bmander/interferometer/renders/cube_section_side.png

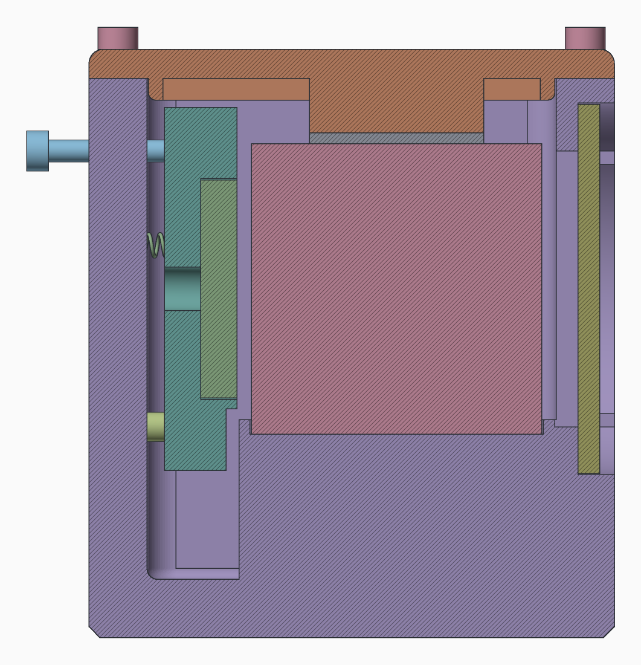
renders/cube_section_side.png
