bmander/interferometer/renders/mount_front.png

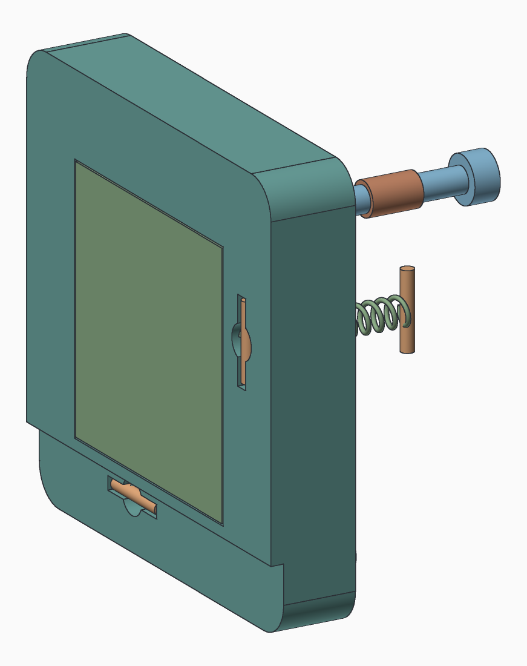
renders/mount_front.png
