bmander/interferometer/stl/carriage.stl

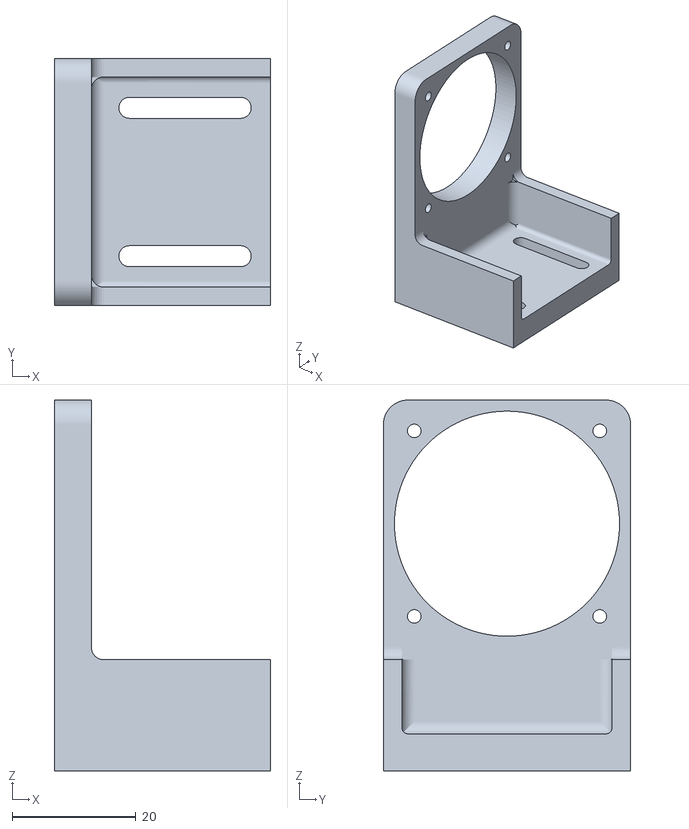
[picture p6: CAD file, 2026-11-11]
stl/carriage.stl
35.0 x 40.0 x 60.0
