bmander/interferometer/stl/housing.stl

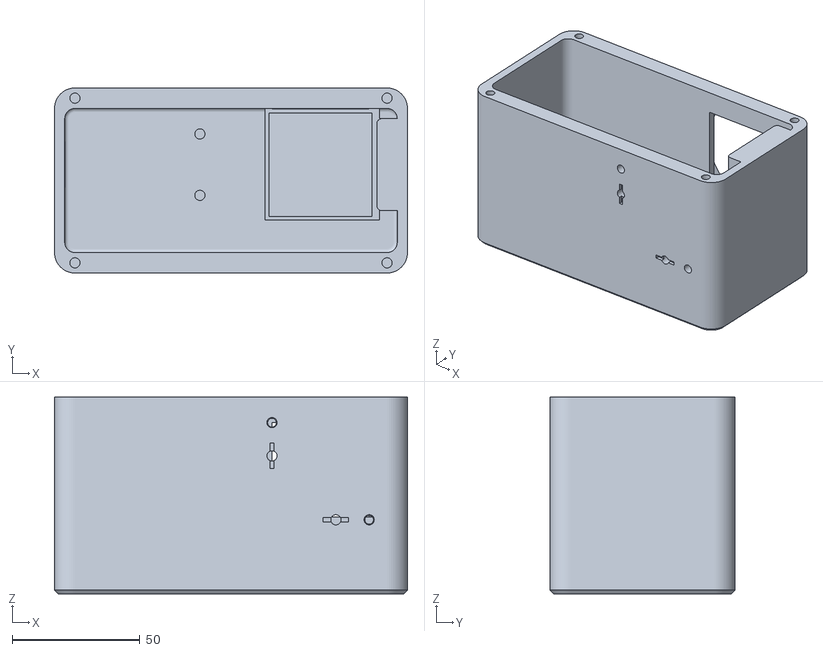
[picture p7: CAD file, 2026-11-11]
stl/housing.stl
138.1 x 72.4 x 77.0
