bmander/interferometer/stl/carrier.stl

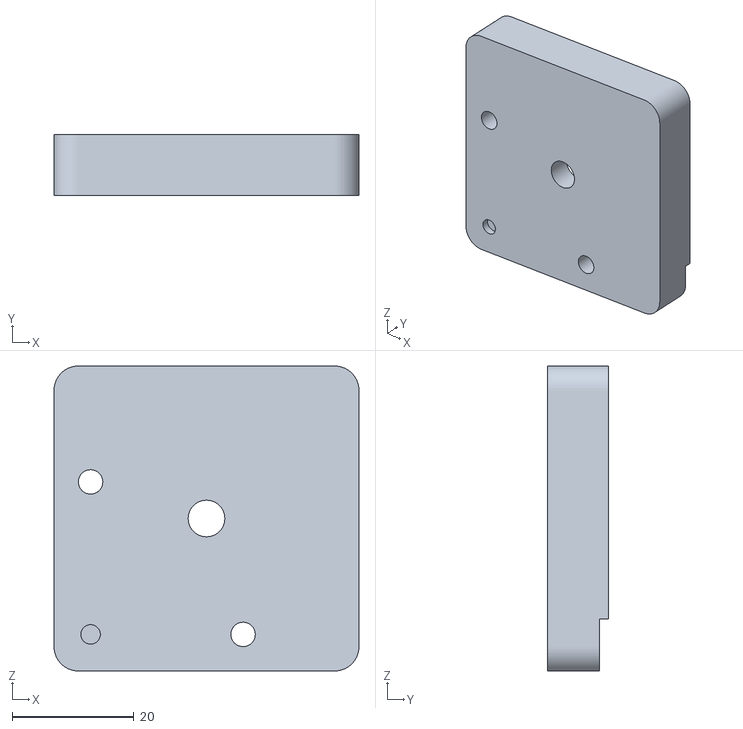
[picture p8: CAD file, 2026-11-11]
stl/carrier.stl
50.0 x 10.0 x 50.0
