bmander/interferometer/stl/lid.stl

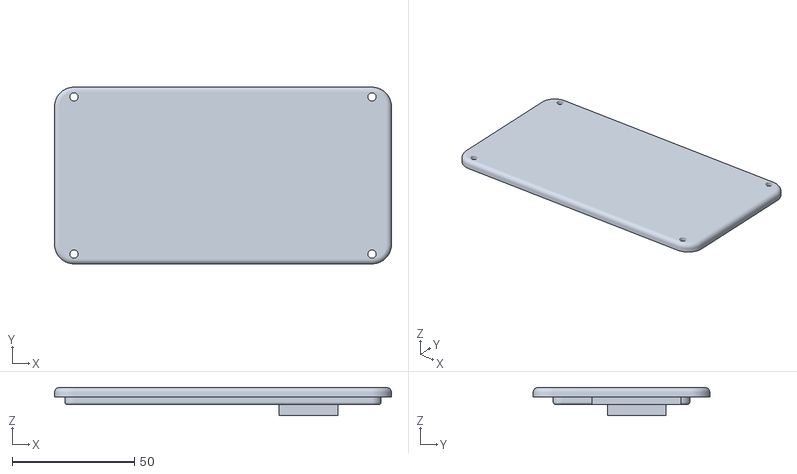
[picture p9: CAD file, 2026-11-11]
stl/lid.stl
138.1 x 72.4 x 11.5
