bmander/interferometer/renders/assembly.png

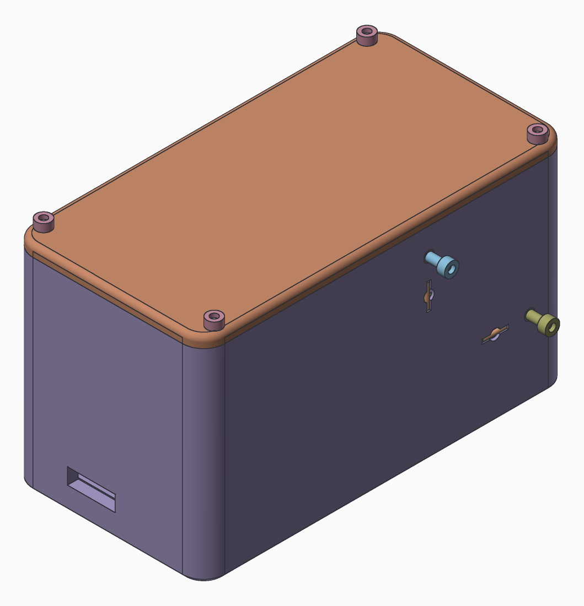
renders/assembly.png
