bmander/interferometer/renders/assembly_back.png

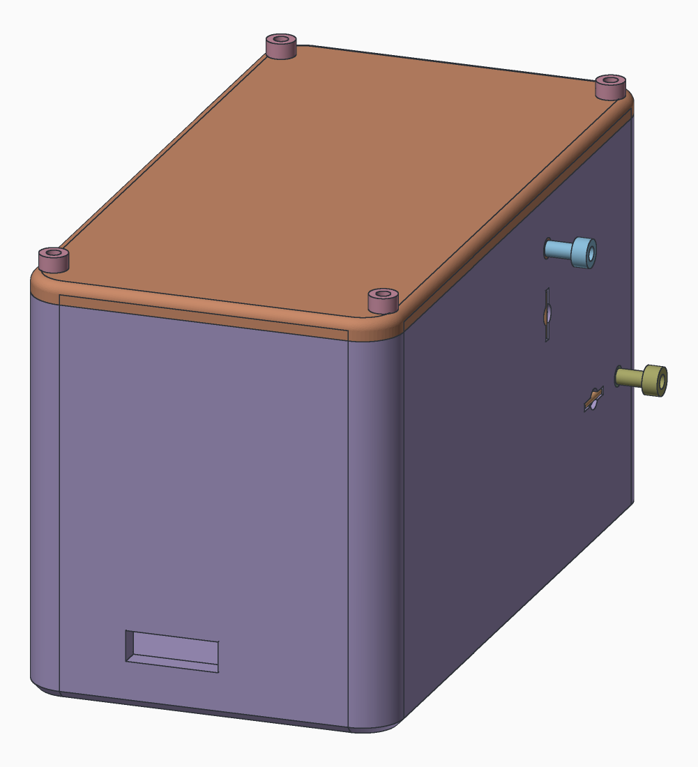
renders/assembly_back.png
