bmander/interferometer/renders/assembly_section.png

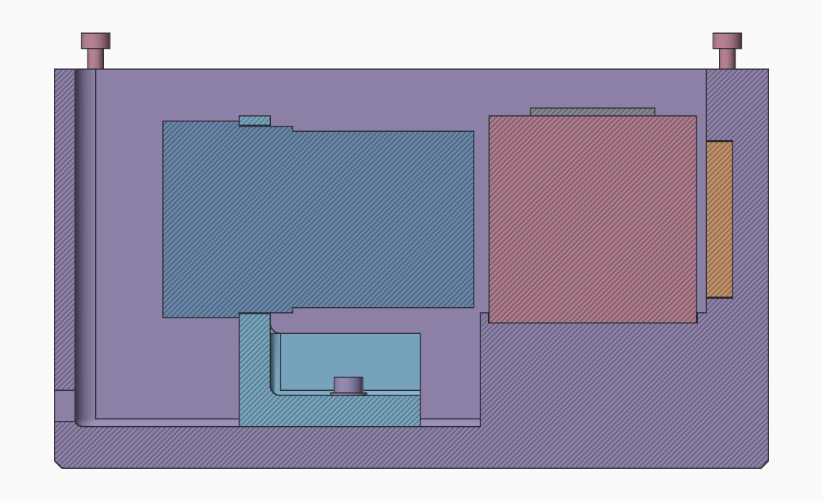
renders/assembly_section.png
