bmander/interferometer/renders/assembly_top.png

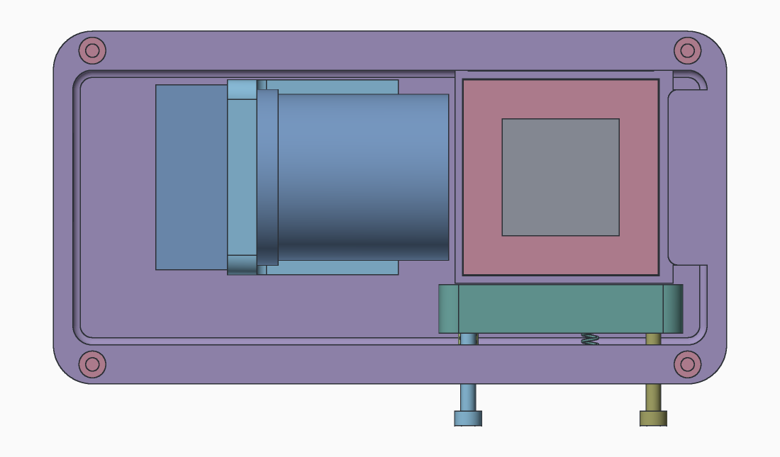
renders/assembly_top.png
