bmander/interferometer/head/housing.sv

// The housing: one print holding the beamsplitter cube, both mirrors and the camera carriage.
//
// A floor with four walls, open at the top for the lid, its corners rounded, its floor's edge
// chamfered and its walls filleted inside.  On the floor, the cube's pedestal with
// a shallow recess that fixes the cube square to the world's axes; the lid's padded post holds
// it down.  The +x wall thickens into a boss whose face carries the fixed mirror B `gap` off
// the cube.  The back wall is thick: it takes mirror A's pivot ball and the two adjuster screws'
// inserts, from behind, where you stand.  The front wall has the square window and, outside it,
// the pocket for the 2" 532 nm filter.  The camera's ribbon leaves through a slot low in the -x
// wall, and four M5 inserts underneath bolt the head to its frame.

unit mm
use std
use std.solids (union, cut)
use std.rounds (round, chamfer)
use head.prims
use head.dims (cube, h, gap, mirror_w, mirror_t, mirror_face, fit, floor_t, wall_t, front_in,
               front_out, back_in, back_out, side_in, x_in, top, recess_d, recess_rim, boss_w, window,
               filter_d, filter_t, lever, seat, seat_deep, spring_hole, spring_run, groove,
               groove_l, m3_insert_d, m3_insert_l, m3_clear, m5_insert_d, m5_insert_l, foot_x,
               slot_y, lid_x, mount_dx, mount_dy, mount_cx, mount_cy, corner_r, base_chamfer,
               inner_r, fillet)

component Housing() {
  // -- material ---------------------------------------------------------------------------------
  // One box, its corners rounded `corner_r` in plan and its floor's edge chamfered all round
  // (the edge it prints on), hollowed by a soft box whose corners leave the walls filleted
  // into the floor and into one another.
  shell := head.prims.Block(x0: x_in - wall_t, x1: side_in + wall_t, y0: -back_out, y1: front_out,
                            z0: -floor_t, z1: top)
  cavity := head.prims.SoftBox(x0: x_in, x1: side_in, y0: -back_in, y1: front_in, z0: 0mm,
                               z1: top + 2 * corner_r, r: inner_r, e: fillet)
  // the cube stands in a recess in the pedestal, `recess_d` deep, its bottom face `h - cube / 2`
  // up; the pedestal runs on into the fixed mirror's boss and the front wall
  pedestal := head.prims.Block(x0: -recess_rim, x1: mirror_face + 1mm, y0: -recess_rim,
                               y1: front_in + 1mm, z0: -1mm, z1: h - cube / 2 + recess_d)
  // mirror B's boss: its face is the mirror's surface plane, `gap` off the cube's +x face
  boss := head.prims.Block(x0: mirror_face, x1: side_in + 1mm, y0: -boss_w / 2, y1: boss_w / 2,
                           z0: -1mm, z1: top)

  // the walls are a solid of their own, hollowed before the pedestal and boss join them: a
  // body's unions come before its cuts
  box := solid(shell.body)
  repeat f in box.shell { repeat g in box.shell {
    when f parallel std.z and g parallel std.z and f != g { f round(r: corner_r) g } } }
  walls := solid(box)        // the box as its corners leave it, so the chamfer runs round them
  walls.box.shell.body.far chamfer(d: base_chamfer) walls.box
  cavity.body cut walls
  body := solid(walls)
  pedestal.body union body
  boss.body union body
  // the boss's two front corners, rounded
  body.boss.body.da round(r: 2mm) body.boss.body.ab
  body.boss.body.da round(r: 2mm) body.boss.body.cd

  recess := head.prims.Block(x0: -cube / 2 - fit, x1: cube / 2 + fit, y0: -cube / 2 - fit,
                             y1: cube / 2 + fit, z0: h - cube / 2, z1: h - cube / 2 + recess_d + 1mm)
  recess.body cut body

  // -- mirror B, the window and the filter ------------------------------------------------------
  // the mirror drops into its pocket face out, flush with the boss, and is held by three dots of
  // RTV in the pocket's floor
  mirror_b := head.prims.Block(x0: mirror_face - 1mm, x1: mirror_face + mirror_t,
                               y0: -mirror_w / 2 - fit, y1: mirror_w / 2 + fit,
                               z0: h - mirror_w / 2 - fit, z1: h + mirror_w / 2 + fit)
  mirror_b.body cut body
  win := head.prims.Block(x0: -window / 2, x1: window / 2, y0: front_in - 0.2mm, y1: front_out + 1mm,
                          z0: h - window / 2, z1: h + window / 2)
  win.body cut body
  filter := head.prims.BoreY(x: 0mm, z: h, d: filter_d + 2 * fit, y0: front_out - filter_t,
                             y1: front_out + 1mm)
  filter.body cut body

  // -- mirror A's kinematic mount, in the back wall --------------------------------------------
  // Seen from behind: the pivot ball's seat low and toward the camera; the horizontal-shear
  // adjuster `lever` across from it, the vertical-shear one `lever` above it.  Each adjuster is
  // an M3 heat-set insert pressed in from behind, its screw running through to push the carrier.
  pivot := head.prims.BoreY(x: -lever / 2, z: h - lever / 2, d: seat, y0: -back_in - seat_deep,
                            y1: -back_in + 1mm)
  pivot.body cut body
  repeat a in [(lever / 2, -lever / 2), (-lever / 2, lever / 2)] {
    insert := head.prims.BoreY(x: a.x, z: h + a.y, d: m3_insert_d, y0: -back_out - 1mm,
                               y1: -back_out + m3_insert_l)
    insert.body cut body
    through := head.prims.BoreY(x: a.x, z: h + a.y, d: m3_clear, y0: -back_out - 1mm,
                                y1: -back_in + 1mm)
    through.body cut body
  }
  // the springs: one along the bottom edge from the pivot, one up the side; each passes through
  // the wall and hooks on a pin lying in a groove across its hole outside
  s_low := head.prims.BoreY(x: -lever / 2 + spring_run, z: h - lever / 2, d: spring_hole,
                            y0: -back_out - 1mm, y1: -back_in + 1mm)
  s_low.body cut body
  g_low := head.prims.Block(x0: -lever / 2 + spring_run - groove_l / 2,
                            x1: -lever / 2 + spring_run + groove_l / 2,
                            y0: -back_out - 1mm, y1: -back_out + groove,
                            z0: h - lever / 2 - groove / 2, z1: h - lever / 2 + groove / 2)
  g_low.body cut body
  s_side := head.prims.BoreY(x: -lever / 2, z: h - lever / 2 + spring_run, d: spring_hole,
                             y0: -back_out - 1mm, y1: -back_in + 1mm)
  s_side.body cut body
  g_side := head.prims.Block(x0: -lever / 2 - groove / 2, x1: -lever / 2 + groove / 2,
                             y0: -back_out - 1mm, y1: -back_out + groove,
                             z0: h - lever / 2 + spring_run - groove_l / 2,
                             z1: h - lever / 2 + spring_run + groove_l / 2)
  g_side.body cut body

  // -- the camera: its carriage's two inserts, and the ribbon's way out --------------------------
  repeat sy in [-slot_y, slot_y] {
    cam_insert := head.prims.BoreZ(x: foot_x, y: sy, d: m3_insert_d, z0: -m3_insert_l, z1: 1mm)
    cam_insert.body cut body
  }
  ribbon := head.prims.Block(x0: x_in - wall_t - 1mm, x1: x_in + 1mm, y0: -9mm, y1: 9mm,
                             z0: 1mm, z1: 7mm)
  ribbon.body cut body

  // -- the lid's inserts, in the tops of the front and back walls -------------------------------
  repeat lx in lid_x {
    repeat ly in [-(back_in + back_out) / 2, (front_in + front_out) / 2] {
      lid_insert := head.prims.BoreZ(x: lx, y: ly, d: m3_insert_d, z0: top - m3_insert_l, z1: top + 1mm)
      lid_insert.body cut body
    }
  }

  // -- the frame's M5 inserts, from underneath -------------------------------------------------
  repeat mx in [mount_cx - mount_dx / 2, mount_cx + mount_dx / 2] {
    repeat my in [mount_cy - mount_dy / 2, mount_cy + mount_dy / 2] {
      m5 := head.prims.BoreZ(x: mx, y: my, d: m5_insert_d, z0: -floor_t - 1mm,
                             z1: -floor_t + m5_insert_l)
      m5.body cut body
    }
  }
}

preview {
  housing := Housing()
}
