bmander/interferometer/(commit log)

2026-11-10 Shearography head for guitar soundboard modal analysis
    A Michelson shearing interferometer in front of a Raspberry Pi Global
    Shutter Camera, modelled in Solvent (solventc v0.1.16): the dimension
    table with its optics claims, four printed parts (housing, tip/tilt
    mirror carrier, camera carriage, lid), stand-ins for the bought optics,
    the assembly with clearance claims, exported STLs and renders.
    [carriage.stl, carrier.stl, housing.stl, lid.stl]
2026-11-10 Hold the beamsplitter cube in a recess, pressed down by the lid
    The cube now sits in a 2 mm recess in its pedestal, which fixes its
    place and turn, and a post under the lid presses it down through a
    2 mm pad. The recess's rim is claimed to stay below the field. To fit
    the rim, the carrier's lower front edge is stepped back 1.5 mm and the
    front gap grows to 2 mm. The two ledges are gone.
    [carrier.stl, housing.stl, lid.stl]
2026-11-11 Add mount hardware, part numbers, and a rounded finish with a locating lid lip
    - head/hardware.sv: mirror A's pivot ball, adjusters, inserts, spring pins and
    every fastener; the two McMaster 5108N95 extension springs drawn as coils in
    head.sv, with claims on their stretch and clearance
    - BOM: Edmund #32-506 cube, Edmund #63-165 mirrors, McMaster 5108N95 springs
    - Round the box's corners and edges (std.rounds.Grown), fillet the walls into
    the floor, round the carrier and carriage, fillet the carriage's ribs
    - Lid: a 3 mm lip running inside the walls and round the mirror boss, with a
    rounded lead-in; lid screws moved onto the corners' centres
    - Carriage: slots now end inside a longer f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
    [carriage.stl, carrier.stl, housing.stl, lid.stl]
2026-11-11 Port to solventc v0.1.17: chamfered base, foot fillet back, list rounds
    v0.1.17 fixes geomsolver #879, #881 and #882, which this model worked around:
    - Housing: the floor edge is a 1.5 mm chamfer run round the rounded corners
    (a rim over earlier rounds, #879) instead of a 2 mm round on the print bed
    - Carriage: the foot-to-plate fillet is back (2 mm), stopping flush at the
    slots (#881); the slots start past it so a washer clears it, and the foot
    grows to 29 mm to keep travel at +/-9 mm, still clear of the pedestal
    - Carrier: its four corner rounds are one loop over a list of faces (#882)
    - Rebuild STLs and renders; README names v0.1.17 and the new finish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
    [carriage.stl, carrier.stl, housing.stl]
